Bowuzu/Analog-Neural-Network/ANN_Kicad.kicad_sch

## KiCad design ANN_Kicad.kicad_sch (2026-07-17, an earlier design)

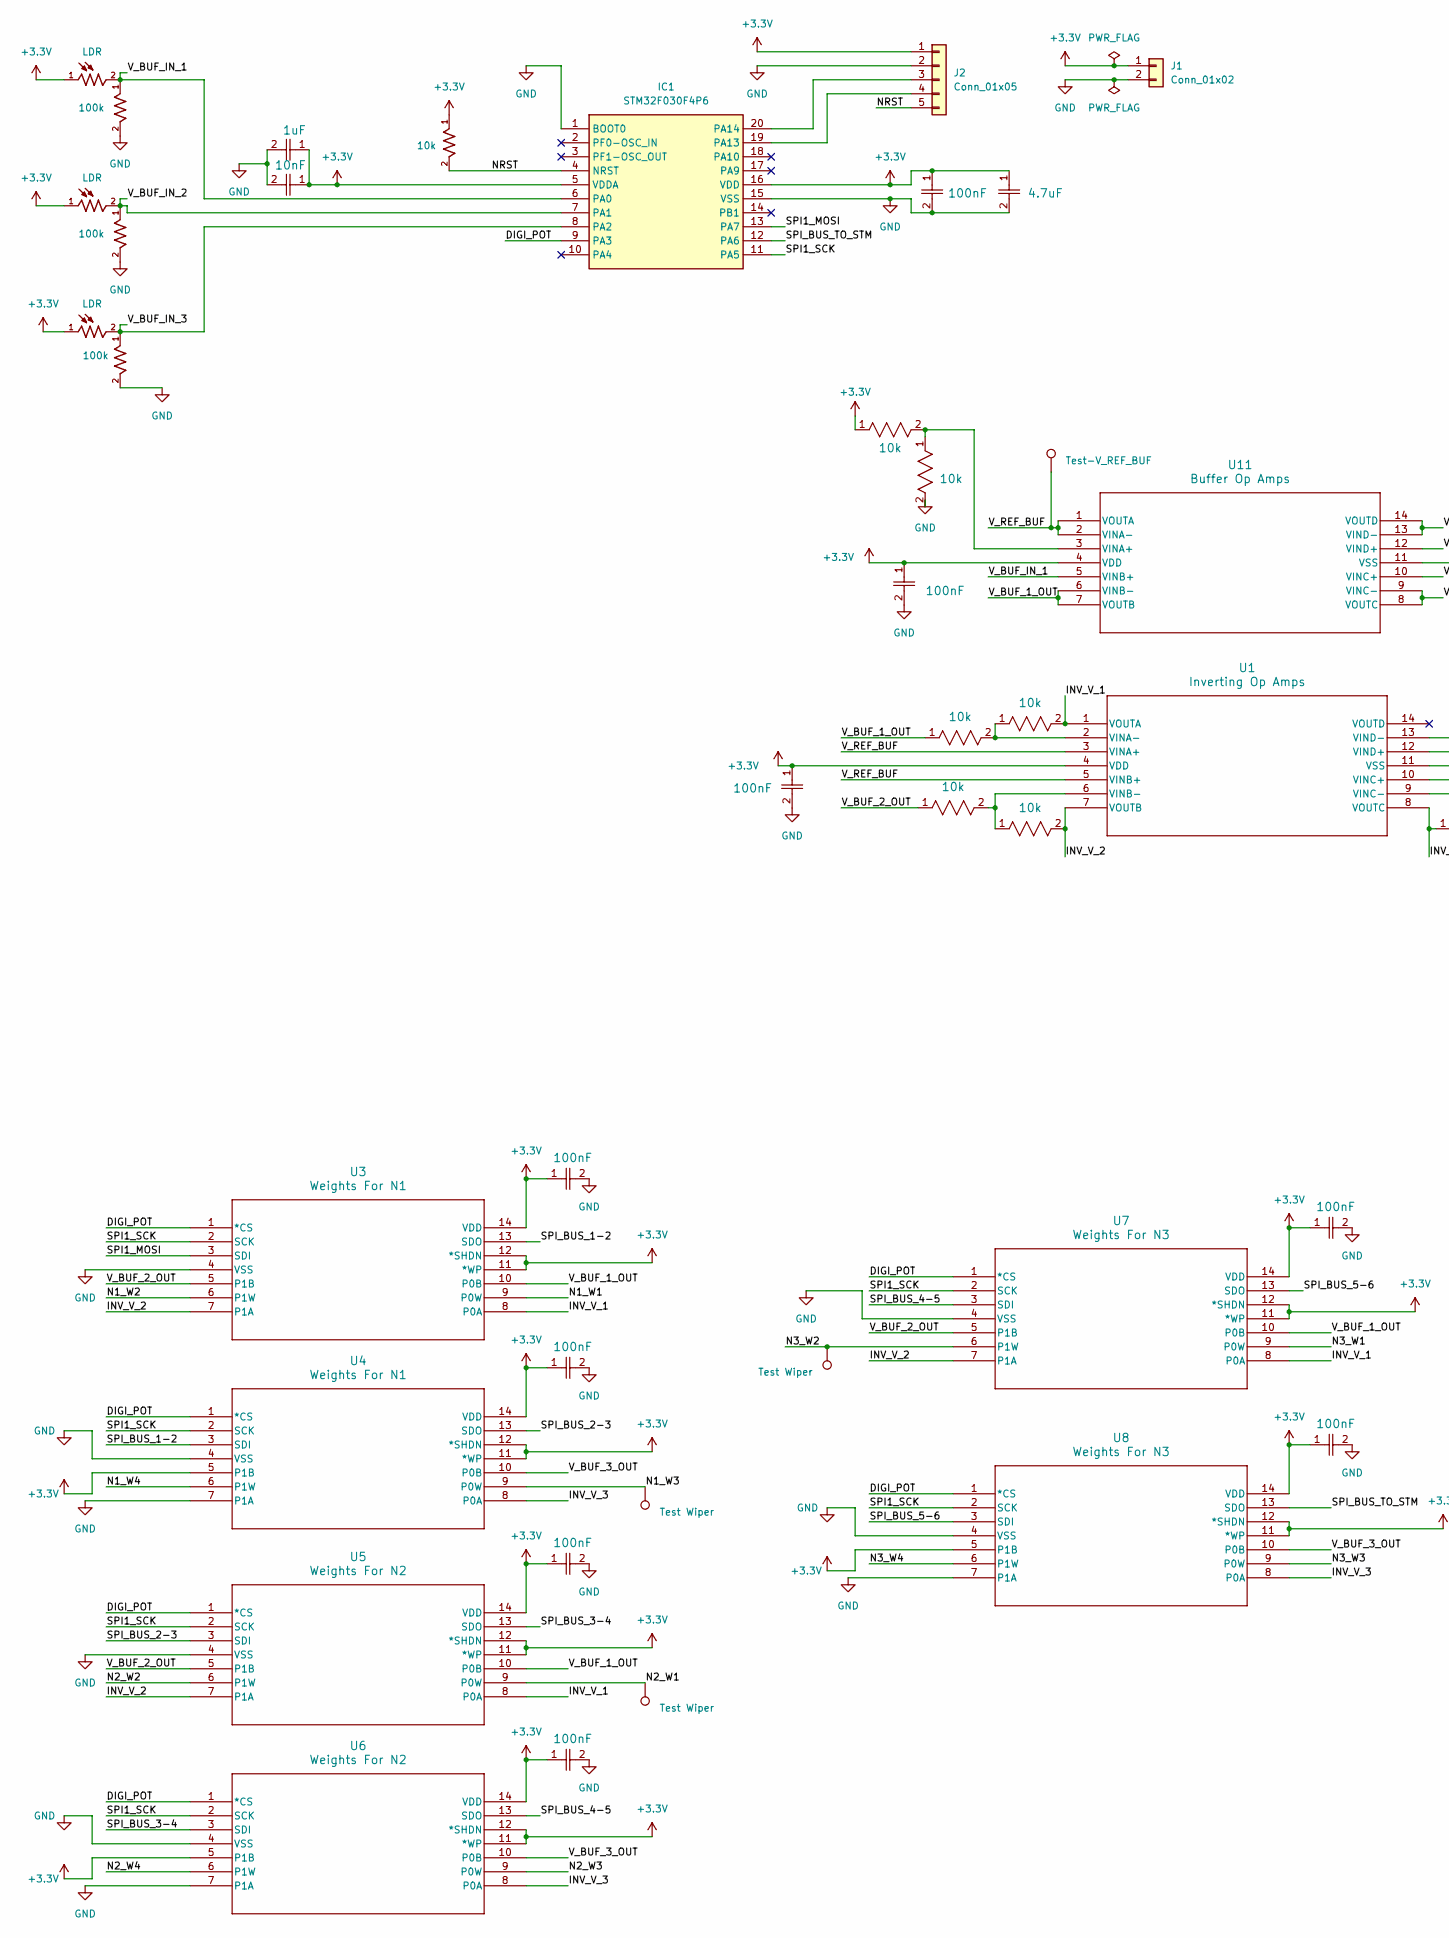
[picture p1: schematic ANN_Kicad.kicad_sch, part in row 1, column 1]

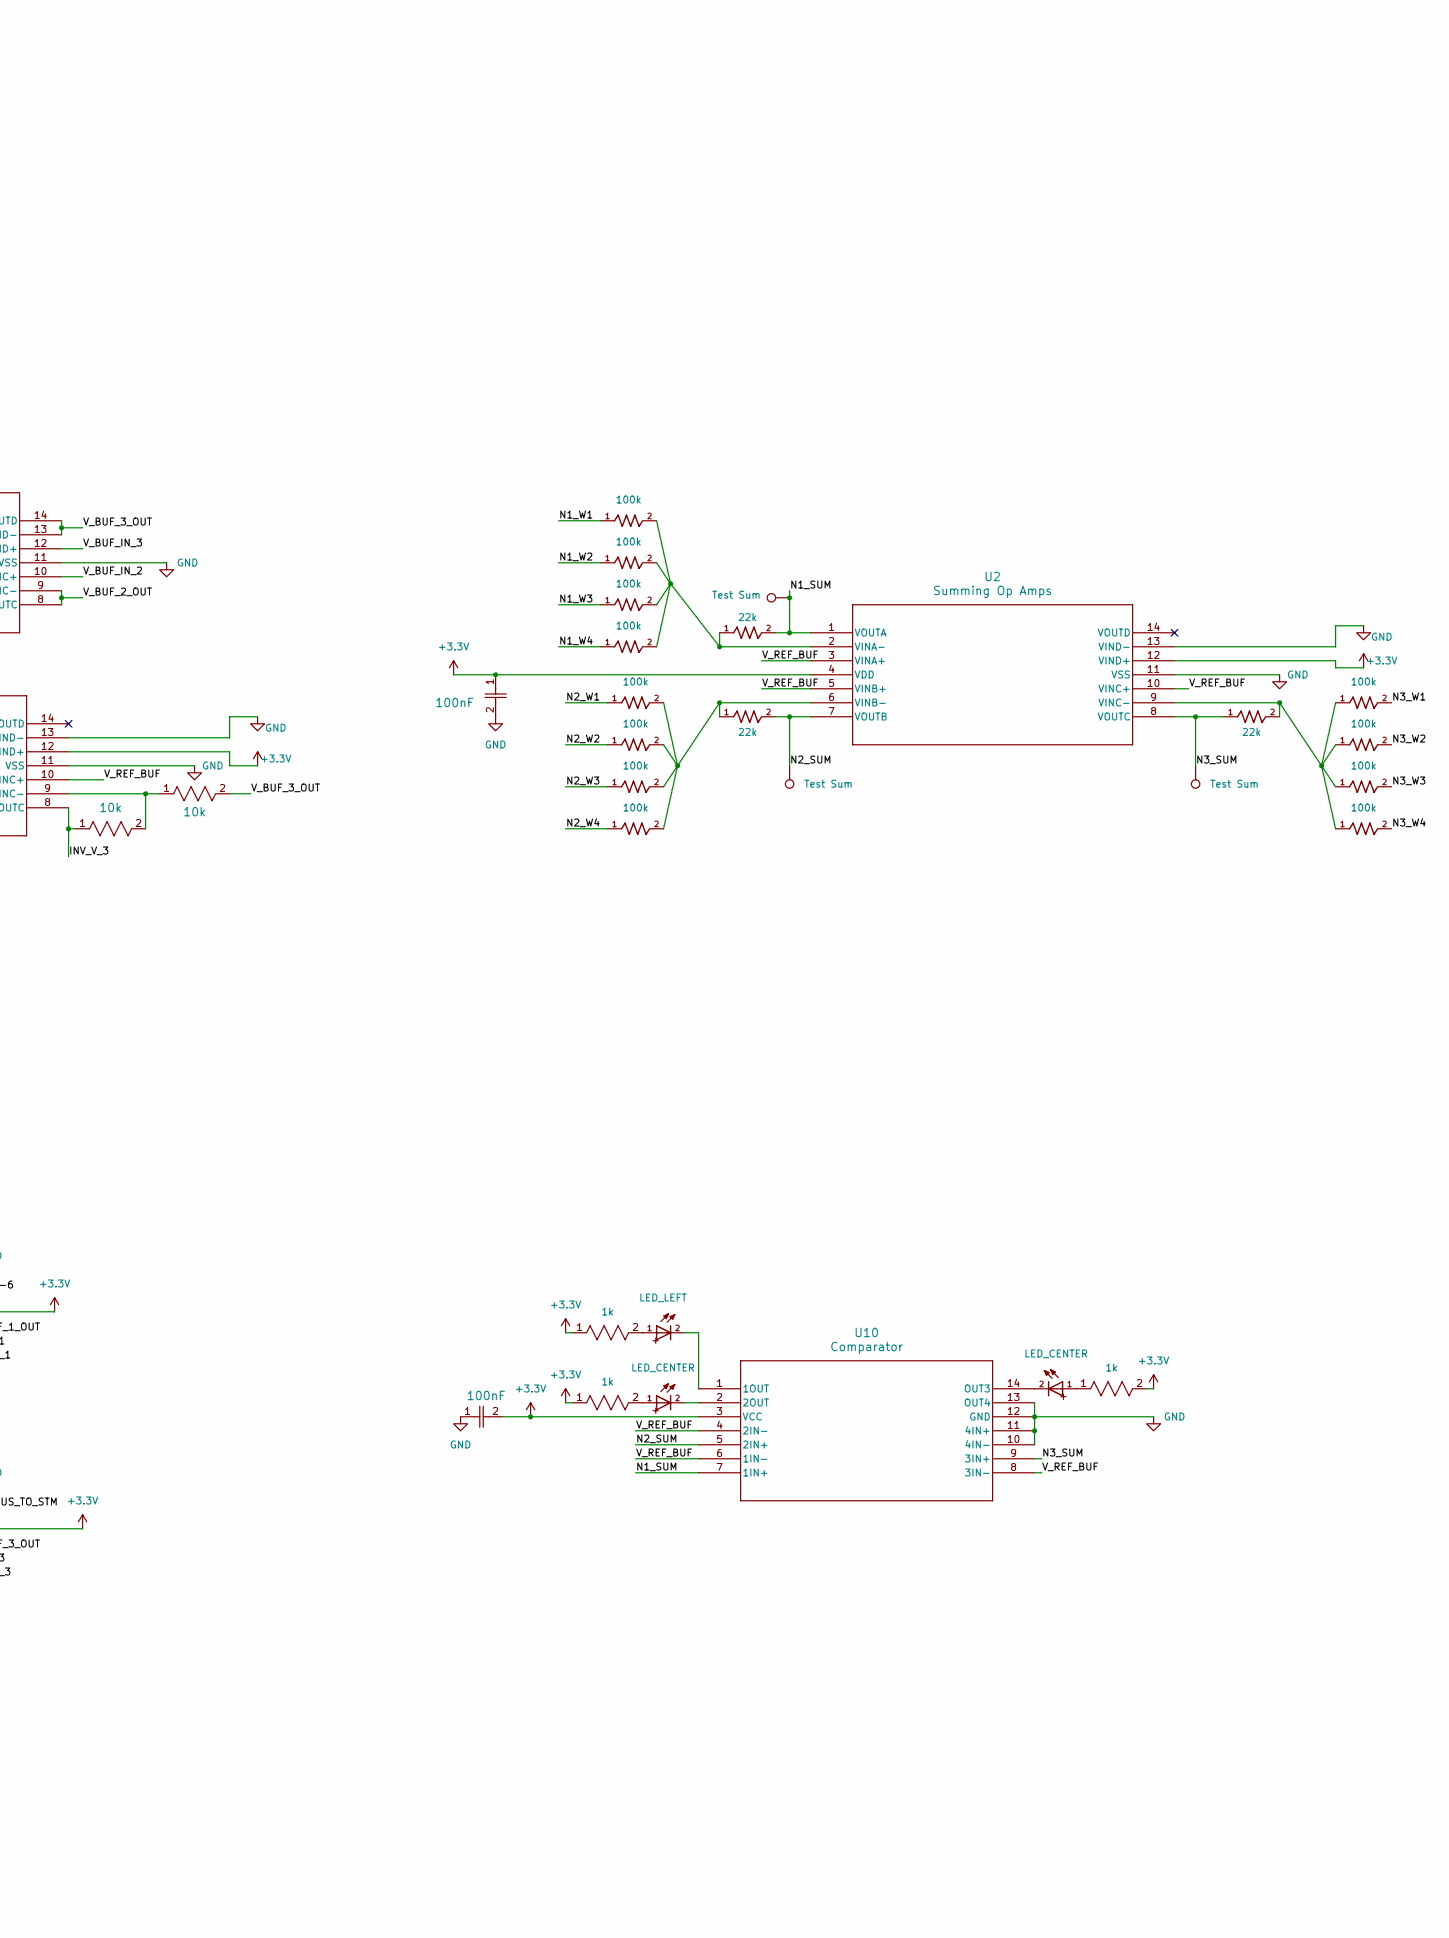
[picture p2: schematic ANN_Kicad.kicad_sch, part in row 1, column 2]

Parts:
C1, C5, C6, C7, C8, C9, C10, C11, C12, C13, C14: 100nF; CAP_CC0603KRX7R8BB104_YAG-M
C2: 4.7uF; CAP_CL10_SAM-M
C3: 10nF; CAP_CC0603KRX7R8BB104_YAG-M
C4: 1uF; CAP_CC0603KRX7R8BB104_YAG-M
D1: LED_LEFT; WL-TMRC_5MM
D2, D3: LED_CENTER; WL-TMRC_5MM
IC1: STM32F030F4P6; SOP65P640X120-20N; Manufacturer_Part_Number STM32F030F4P6; Mouser Part Number 511-STM32F030F4P6
J1: Conn_01x02
J2: Conn_01x05
R1, R2, R3: LDR; PHODET_PDV-P8103; PARTREV 3/30/06
R4, R5, R6, R15, R16, R17, R18, R20, R21, R22, R23, R25, R26, R27, R28: 100k; RESC1508X50N
R7, R8, R9, R10, R11, R12, R13, R14: 10k; RC0603N_YAG
R19, R24, R29: 22k; RESC1608X55N
R30, R31, R32: 1k; RESC1508X50N
R33: 10k; RESC1508X50N
TP1: Test-V_REF_BUF
TP2, TP3, TP4: Test Wiper
TP5, TP6, TP7: Test Sum
U1: Inverting Op Amps; TSSOP14_MC_MCH-M
U2: Summing Op Amps; TSSOP14_MC_MCH-M
U3, U4: Weights For N1; SOIC14-N_MC_MCH-M
U5, U6: Weights For N2; SOIC14-N_MC_MCH-M
U7, U8: Weights For N3; SOIC14-N_MC_MCH-M
U10: Comparator; N14
U11: Buffer Op Amps; TSSOP14_MC_MCH-M

Connections:
+3.3V: C1.1, C2.1, C3.1, C4.1, C5.1, C6.1, C7.1, C8.1, C9.1, C10.1, C11.1, C12.1, C13.1, C14.2, IC1.5 (VDDA), IC1.16 (VDD), J1.1, J2.1, R1.1, R2.1, R3.1, R7.1, R30.1, R31.1, R32.2, R33.1, U1.4 (VDD), U1.12 (VIND+), U2.4 (VDD), U2.12 (VIND+), U3.11 (*WP), U3.12 (*SHDN), U3.14 (VDD), U4.5 (P1B), U4.11 (*WP), U4.12 (*SHDN), U4.14 (VDD), U5.11 (*WP), U5.12 (*SHDN), U5.14 (VDD), U6.5 (P1B), U6.11 (*WP), U6.12 (*SHDN), U6.14 (VDD), U7.11 (*WP), U7.12 (*SHDN), U7.14 (VDD), U8.5 (P1B), U8.11 (*WP), U8.12 (*SHDN), U8.14 (VDD), U10.3 (VCC), U11.4 (VDD)
DIGI_POT: IC1.9 (PA3), U3.1 (*CS), U4.1 (*CS), U5.1 (*CS), U6.1 (*CS), U7.1 (*CS), U8.1 (*CS)
GND: C1.2, C2.2, C3.2, C4.2, C5.2, C6.2, C7.2, C8.2, C9.2, C10.2, C11.2, C12.2, C13.2, C14.1, IC1.1 (BOOT0), IC1.15 (VSS), J1.2, J2.2, R4.2, R5.2, R6.2, R8.2, U1.11 (VSS), U1.13 (VIND-), U2.11 (VSS), U2.13 (VIND-), U3.4 (VSS), U4.4 (VSS), U4.7 (P1A), U5.4 (VSS), U6.4 (VSS), U6.7 (P1A), U7.4 (VSS), U8.4 (VSS), U8.7 (P1A), U10.10 (4IN-), U10.11 (4IN+), U10.12 (GND), U10.13 (OUT4), U11.11 (VSS)
INV_V_1: R10.2, U1.1 (VOUTA), U3.8 (P0A), U5.8 (P0A), U7.8 (P0A)
INV_V_2: R12.2, U1.7 (VOUTB), U3.7 (P1A), U5.7 (P1A), U7.7 (P1A)
INV_V_3: R14.1, U1.8 (VOUTC), U4.8 (P0A), U6.8 (P0A), U8.8 (P0A)
N1_SUM: R19.2, TP6.1, U2.1 (VOUTA), U10.7 (1IN+)
N1_W1: R15.1, U3.9 (P0W)
N1_W2: R16.1, U3.6 (P1W)
N1_W3: R17.1, TP2.1, U4.9 (P0W)
N1_W4: R18.1, U4.6 (P1W)
N2_SUM: R24.2, TP5.1, U2.7 (VOUTB), U10.5 (2IN+)
N2_W1: R20.1, TP3.1, U5.9 (P0W)
N2_W2: R21.1, U5.6 (P1W)
N2_W3: R22.1, U6.9 (P0W)
N2_W4: R23.1, U6.6 (P1W)
N3_SUM: R29.1, TP7.1, U2.8 (VOUTC), U10.9 (3IN+)
N3_W1: R25.2, U7.9 (P0W)
N3_W2: R26.2, TP4.1, U7.6 (P1W)
N3_W3: R27.2, U8.9 (P0W)
N3_W4: R28.2, U8.6 (P1W)
NRST: IC1.4 (NRST), J2.5, R33.2
unnamed: D1.1, R30.2
unnamed: D1.2, U10.1 (1OUT)
unnamed: D2.1, R31.2
unnamed: D2.2, U10.2 (2OUT)
unnamed: D3.1, R32.1
unnamed: D3.2, U10.14 (OUT3)
unnamed: IC1.19 (PA13), J2.4
unnamed: IC1.20 (PA14), J2.3
unnamed: R7.2, R8.1, U11.3 (VINA+)
unnamed: R9.2, R10.1, U1.2 (VINA-)
unnamed: R11.2, R12.1, U1.6 (VINB-)
unnamed: R13.1, R14.2, U1.9 (VINC-)
unnamed: R15.2, R16.2, R17.2, R18.2, R19.1, U2.2 (VINA-)
unnamed: R20.2, R21.2, R22.2, R23.2, R24.1, U2.6 (VINB-)
unnamed: R25.1, R26.1, R27.1, R28.1, R29.2, U2.9 (VINC-)
SPI1_MOSI: IC1.13 (PA7), U3.3 (SDI)
SPI1_SCK: IC1.11 (PA5), U3.2 (SCK), U4.2 (SCK), U5.2 (SCK), U6.2 (SCK), U7.2 (SCK), U8.2 (SCK)
SPI_BUS_1-2: U3.13 (SDO), U4.3 (SDI)
SPI_BUS_2-3: U4.13 (SDO), U5.3 (SDI)
SPI_BUS_3-4: U5.13 (SDO), U6.3 (SDI)
SPI_BUS_4-5: U6.13 (SDO), U7.3 (SDI)
SPI_BUS_5-6: U7.13 (SDO), U8.3 (SDI)
SPI_BUS_TO_STM: IC1.12 (PA6), U8.13 (SDO)
V_BUF_1_OUT: R9.1, U3.10 (P0B), U5.10 (P0B), U7.10 (P0B), U11.6 (VINB-), U11.7 (VOUTB)
V_BUF_2_OUT: R11.1, U3.5 (P1B), U5.5 (P1B), U7.5 (P1B), U11.8 (VOUTC), U11.9 (VINC-)
V_BUF_3_OUT: R13.2, U4.10 (P0B), U6.10 (P0B), U8.10 (P0B), U11.13 (VIND-), U11.14 (VOUTD)
V_BUF_IN_1: IC1.6 (PA0), R1.2, R5.1, U11.5 (VINB+)
V_BUF_IN_2: IC1.7 (PA1), R2.2, R6.1, U11.10 (VINC+)
V_BUF_IN_3: IC1.8 (PA2), R3.2, R4.1, U11.12 (VIND+)
V_REF_BUF: TP1.1, U1.3 (VINA+), U1.5 (VINB+), U1.10 (VINC+), U2.3 (VINA+), U2.5 (VINB+), U2.10 (VINC+), U10.4 (2IN-), U10.6 (1IN-), U10.8 (3IN-), U11.1 (VOUTA), U11.2 (VINA-)
