Bowuzu/Analog-Neural-Network/(commit log)

2026-07-17 Initial commit: ANN KiCad project
    [ANN_Kicad.kicad_pcb, ANN_Kicad.kicad_sch]
2026-07-17 sim: verify TLV7034 comparator fix, add model validation
    Revision 1 found the LM339 decision stage unworkable at 3.3 V: its
    common-mode ceiling (1.80 V datasheet / 1.30 V model) sits below the
    1.65 V reference, so no input value could produce a valid comparison.
    The schematic's comparator was changed to a TLV7034; this re-runs the
    affected decks against the new part.
    Add models/TLV7034.lib -- TI's PSpice model, literature SLVMDH3, verbatim
    apart from CRLF->LF. Documents three model/datasheet divergences found
    while validating it, and wraps TI's port order (IN+ IN- OUT V+ V-) to the
    project's house order rather than re-ordering ports at each call site.
    Add tb10_tlv7034_validation.cir, follo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
2026-07-17 sch: replace comparator with TLV7034, correct component values
    Comparator LM339N (U10) -> PTLV7034PWR (U9, TI TLV7034 quad, TSSOP-14).
    Rail-to-rail inputs (VCM = V- .. V+ +0.1 = 0..3.40 V at 3.3 V) cover the
    0.198..3.0997 V sum swing and the 1.65 V reference with margin; internal
    hysteresis (10 mV typ) and a push-pull output remove the chatter and the
    missing-pull-up findings. Verified in sim/ -- see tb06, tb08, tb10.
    Resistor and capacitor values: in each case the Value field was already
    the design intent and the placed part was wrong. Because every part here
    is an UltraLibrarian download whose symbol name IS the MPN
    (CRCW0603100KFKEA = 100k), editing the Value field only relabels -- the
    p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
    [ANN_Kicad.kicad_sch]
